andreili/UniEmu/hardware/out_buck.xlsx

 | nom | max
Vin | 5 | 5.5
Vout | 2.5
Io | 3 | 4
Fsw | 0.5
Kind | 0.2
Vpp | 0.2
R1 | 47
Lo | 4.166666667
Los | 4.7
Iripple | 0.5319148936
 | 0.580270793
Ilrms | 4.702984108
C | 2.5
R2(3.3) | 15.04 | 15 | 3.306666667
R2(2,5) | 22.11764706 | 22 | 2.509090909
R2(1,2) | 94 | 91 | 1.213186813
