andreili/UniEmu/hardware/UniEmu.kicad_pcb

## KiCad design hardware/UniEmu.kicad_pcb (2019-04-28)

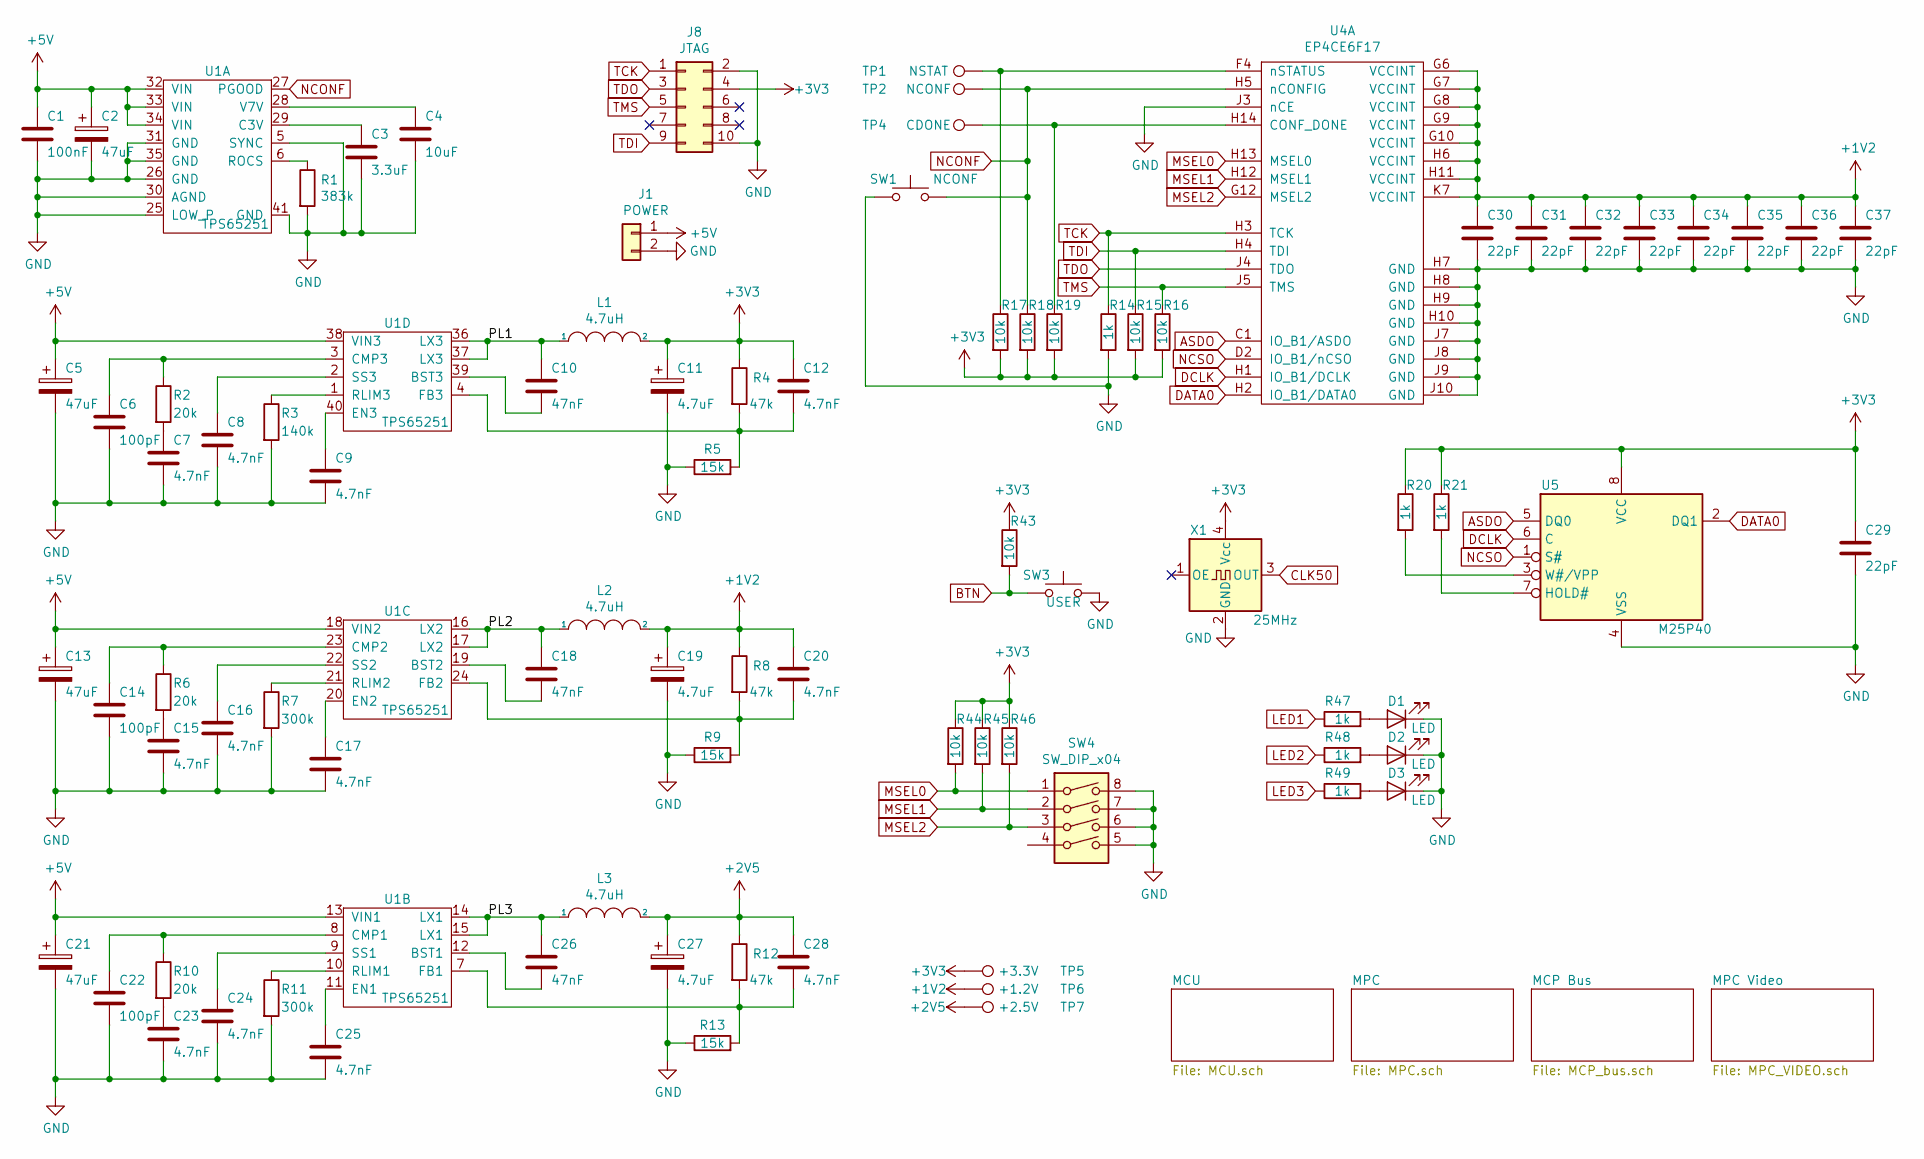
[picture p1: schematic UniEmu.sch]

Parts:
C1: 100nF; C_0805_2012Metric
C2, C5, C13, C21: 47uF; CP_EIA-3528-12_Kemet-T
C3: 3.3uF; C_0805_2012Metric
C4: 10uF; C_1206_3216Metric_Pad1.42x1.75mm_HandSolder
C6, C14, C22: 100pF; C_0805_2012Metric
C7, C8, C9, C12, C15, C16, C17, C20, C23, C24, C25, C28: 4.7nF; C_0805_2012Metric
C10, C18, C26: 47nF; C_0805_2012Metric
C11, C19, C27: 4.7uF; C_0805_2012Metric
C29, C30, C31, C32, C33, C34, C35, C36, C37: 22pF; C_0805_2012Metric
D1, D2, D3: LED; LED_0805_2012Metric_Castellated
J1: POWER; BarrelJack_Horizontal
J8: JTAG; IDC-Header_2x05_P2.54mm_Vertical
L1: 4.7uH; L_TDK_VLF10040
L2, L3: 4.7uH; L_Taiyo-Yuden_MD-4040
R1: 383k; R_0805_2012Metric
R2, R6, R10: 20k; R_0805_2012Metric
R3: 140k; R_0805_2012Metric
R4, R8, R12: 47k; R_0805_2012Metric
R5, R9, R13: 15k; R_0805_2012Metric
R7, R11: 300k; R_0805_2012Metric
R14, R20, R21, R47, R48, R49: 1k; R_0805_2012Metric
R15, R16, R17, R18, R19, R43, R44, R45, R46: 10k; R_0805_2012Metric
SW1: NCONF; SW_SPST_CK_RS282G05A3
SW3: USER; SW_SPST_CK_RS282G05A3
SW4: SW_DIP_x04; SW_DIP_SPSTx04_Slide_6.7x11.72mm_W8.61mm_P2.54mm_LowProfile
TP1: NSTAT; TestPoint_Pad_D1.5mm
TP2: NCONF; TestPoint_Pad_D1.5mm
TP4: CDONE; TestPoint_Pad_D1.5mm
TP5: +3.3V; TestPoint_Pad_D1.5mm
TP6: +1.2V; TestPoint_Pad_D1.5mm
TP7: +2.5V; TestPoint_Pad_D1.5mm
U1: TPS65251; QFN-40-1EP_6x6mm_P0.5mm_EP4.6x4.6mm_ThermalVias
U4: EP4CE6F17; BGA-256_17.0x17.0mm_Layout16x16_P1.0mm_Ball0.5mm_Pad0.4mm_N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
U5: M25P40; SOIC-8_3.9x4.9mm_P1.27mm
X1: 25MHz; Crystal_SMD_7050-4Pin_7.0x5.0mm

Connections:
+1V2: C19.1, C20.1, C30.1, C31.1, C32.1, C33.1, C34.1, C35.1, C36.1, C37.1, L2.2, R8.1, TP6.1, U4.G6 (VCCINT), U4.G7 (VCCINT), U4.G8 (VCCINT), U4.G9 (VCCINT), U4.G10 (VCCINT), U4.H6 (VCCINT), U4.H11 (VCCINT), U4.K7 (VCCINT); also elsewhere on the board
+2V5: C27.1, C28.1, L3.2, R12.1, TP7.1; also elsewhere on the board
+5V: C1.1, C2.1, C5.1, C13.1, C21.1, J1.1, U1.13 (VIN1), U1.18 (VIN2), U1.32 (VIN), U1.33 (VIN), U1.34 (VIN), U1.38 (VIN3); also elsewhere on the board
/PL1: C10.1, L1.1, U1.36 (LX3), U1.37 (LX3)
/PL2: C18.1, L2.1, U1.16 (LX2), U1.17 (LX2)
/PL3: C26.1, L3.1, U1.14 (LX1), U1.15 (LX1)
ASDO: U4.C1 (IO_B1/ASDO), U5.5 (DQ0)
BTN: R43.2, SW3.1; also elsewhere on the board
CLK50: X1.3 (OUT); also elsewhere on the board
DATA0: U4.H2 (IO_B1/DATA0), U5.2 (DQ1)
DCLK: U4.H1 (IO_B1/DCLK), U5.6 (C)
GND: C1.2, C2.2, C3.2, C4.2, C5.2, C6.2, C7.2, C8.2, C9.2, C11.2, C13.2, C14.2, C15.2, C16.2, C17.2, C19.2, C21.2, C22.2, C23.2, C24.2, C25.2, C27.2, C29.2, C30.2, C31.2, C32.2, C33.2, C34.2, C35.2, C36.2, C37.2, D1.1 (K), D2.1 (K), D3.1 (K), J1.2, J8.2, J8.10, R1.2, R3.2, R5.1, R7.2, R9.1, R11.2, R13.1, R14.2, SW1.1, SW3.2, SW4.5, SW4.6, SW4.7, SW4.8, U1.5 (SYNC), U1.25 (LOW_P), U1.26 (GND), U1.30 (AGND), U1.31 (GND), U1.35 (GND), U1.41 (GND), U4.H7 (GND), U4.H8 (GND), U4.H9 (GND), U4.H10 (GND), U4.J3 (nCE), U4.J7 (GND), U4.J8 (GND), U4.J9 (GND), U4.J10 (GND), U5.4 (VSS), X1.2 (GND); also elsewhere on the board
LED1: R47.1; also elsewhere on the board
LED2: R48.1; also elsewhere on the board
LED3: R49.1; also elsewhere on the board
MSEL0: R44.2, SW4.1, U4.H13 (MSEL0)
MSEL1: R45.2, SW4.2, U4.H12 (MSEL1)
MSEL2: R46.2, SW4.3, U4.G12 (MSEL2)
NCONF: R18.1, SW1.2, TP2.1, U1.27 (PGOOD), U4.H5 (nCONFIG)
NCSO: U4.D2 (IO_B1/nCSO), U5.1 (S#)
unnamed: C3.1, U1.29 (C3V)
unnamed: C4.1, U1.28 (V7V)
unnamed: C6.1, R2.1, U1.3 (CMP3)
unnamed: C7.1, R2.2
unnamed: C8.1, U1.2 (SS3)
unnamed: C9.1, U1.40 (EN3)
unnamed: C10.2, U1.39 (BST3)
unnamed: C12.2, R4.2, R5.2, U1.4 (FB3)
unnamed: C14.1, R6.1, U1.23 (CMP2)
unnamed: C15.1, R6.2
unnamed: C16.1, U1.22 (SS2)
unnamed: C17.1, U1.20 (EN2)
unnamed: C18.2, U1.19 (BST2)
unnamed: C20.2, R8.2, R9.2, U1.24 (FB2)
unnamed: C22.1, R10.1, U1.8 (CMP1)
unnamed: C23.1, R10.2
unnamed: C24.1, U1.9 (SS1)
unnamed: C25.1, U1.11 (EN1)
unnamed: C26.2, U1.12 (BST1)
unnamed: C28.2, R12.2, R13.2, U1.7 (FB1)
unnamed: D1.2 (A), R47.2
unnamed: D2.2 (A), R48.2
unnamed: D3.2 (A), R49.2
unnamed: R1.1, U1.6 (ROCS)
unnamed: R3.1, U1.1 (RLIM3)
unnamed: R7.1, U1.21 (RLIM2)
unnamed: R11.1, U1.10 (RLIM1)
unnamed: R17.1, TP1.1, U4.F4 (nSTATUS)
unnamed: R19.1, TP4.1, U4.H14 (CONF_DONE)
unnamed: R20.2, U5.3 (W#/VPP)
unnamed: R21.2, U5.7 (HOLD#)
TCK: J8.1, R14.1, U4.H3 (TCK)
TDI: J8.9, R15.1, U4.H4 (TDI)
TDO: J8.3, U4.J4 (TDO)
TMS: J8.5, R16.1, U4.J5 (TMS)
VREF: C11.1, C12.1, C29.1, J8.4, L1.2, R4.1, R15.2, R16.2, R17.2, R18.2, R19.2, R20.1, R21.1, R43.1, R44.1, R45.1, R46.1, TP5.1, U5.8 (VCC), X1.4 (Vcc); also elsewhere on the board

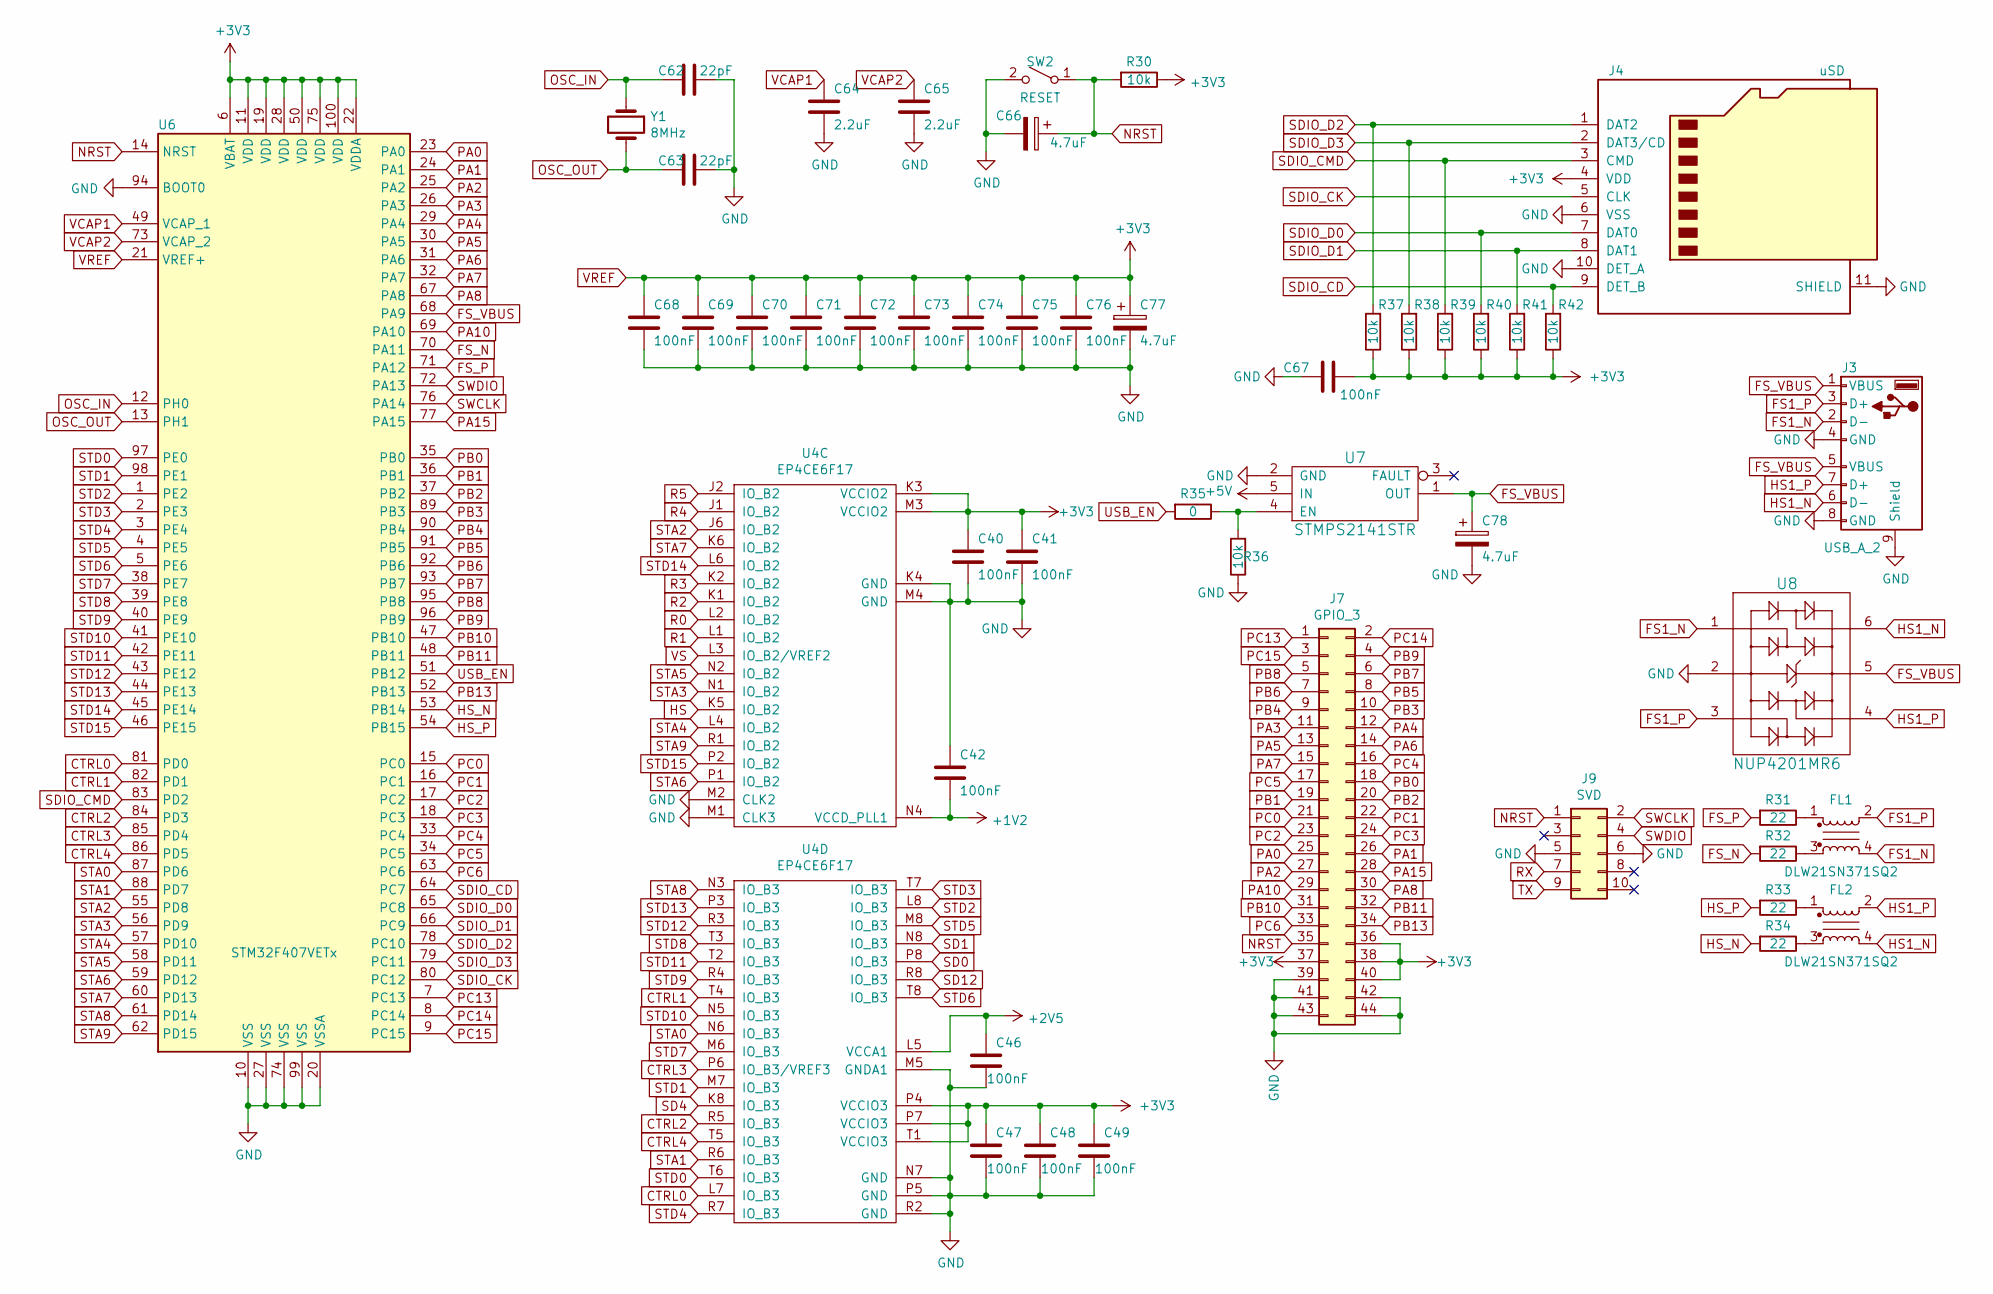
[picture p2: schematic MCU.sch]

Parts:
C40, C41, C42, C46, C47, C48, C49, C67, C68, C69, C70, C71, C72, C73, C74, C75, C76: 100nF; C_0805_2012Metric
C62, C63: 22pF; C_0805_2012Metric
C64, C65: 2.2uF; C_0805_2012Metric
C66: 4.7uF; CP_EIA-3216-18_Kemet-A
C77, C78: 4.7uF; CP_EIA-3528-12_Kemet-T
FL1, FL2: DLW21SN371SQ2; DLW21S
J3: USB_A_2; USB_A_Wuerth_61400826021_Horizontal_Stacked
J4: uSD; Conn_uSDcard
J7: GPIO_3; PinSocket_2x22_P2.00mm_Vertical
J9: SVD; IDC-Header_2x05_P2.54mm_Vertical
R30, R36, R37, R38, R39, R40, R41, R42: 10k; R_0805_2012Metric
R31, R32, R33, R34: 22; R_0402_1005Metric
R35: 0; R_0805_2012Metric
SW2: RESET; SW_Tactile_SPST_Angled_PTS645Vx39-2LFS
U4: EP4CE6F17; BGA-256_17.0x17.0mm_Layout16x16_P1.0mm_Ball0.5mm_Pad0.4mm_N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
U6: STM32F407VETx; LQFP-100_14x14mm_P0.5mm
U7: STMPS2141STR; SOT-23-5_HandSoldering
U8: NUP4201MR6; TSOP-6_1.65x3.05mm_P0.95mm
Y1: 8MHz; Crystal_SMD_5032-2Pin_5.0x3.2mm

Connections:
+1V2: C42.2, U4.N4 (VCCD_PLL1); also elsewhere on the board
+2V5: C46.1, U4.L5 (VCCA1); also elsewhere on the board
+5V: U7.5 (IN); also elsewhere on the board
CTRL0: U4.L7 (IO_B3), U6.81 (PD0)
CTRL1: U4.T4 (IO_B3), U6.82 (PD1)
CTRL2: U4.R5 (IO_B3), U6.84 (PD3)
CTRL3: U4.P6 (IO_B3/VREF3), U6.85 (PD4)
CTRL4: U4.T5 (IO_B3), U6.86 (PD5)
FS1_N: FL1.4, J3.2 (D-), U8.1
FS1_P: FL1.2, J3.3 (D+), U8.3
FS_N: R32.2, U6.70 (PA11)
FS_P: R31.2, U6.71 (PA12)
FS_VBUS: C78.1, J3.1 (VBUS), J3.5 (VBUS), U6.68 (PA9), U7.1 (OUT), U8.5
GND: C40.2, C41.2, C42.1, C46.2, C47.2, C48.2, C49.2, C62.1, C63.1, C64.2, C65.2, C66.2, C67.1, C68.2, C69.2, C70.2, C71.2, C72.2, C73.2, C74.2, C75.2, C76.2, C77.2, C78.2, J3.4 (GND), J3.8 (GND), J3.9 (Shield), J4.6 (VSS), J4.10 (DET_A), J4.11 (SHIELD), J7.39, J7.41, J7.42, J7.43, J7.44, J9.5, J9.6, R36.1, SW2.2 (B), U4.K4 (GND), U4.M1 (CLK3), U4.M2 (CLK2), U4.M4 (GND), U4.M5 (GNDA1), U4.N7 (GND), U4.P5 (GND), U4.R2 (GND), U6.10 (VSS), U6.20 (VSSA), U6.27 (VSS), U6.74 (VSS), U6.94 (BOOT0), U6.99 (VSS), U7.2 (GND), U8.2; also elsewhere on the board
HS: U4.K5 (IO_B2); also elsewhere on the board
HS1_N: FL2.4, J3.6 (D-), U8.6
HS1_P: FL2.2, J3.7 (D+), U8.4
HS_N: R34.2, U6.53 (PB14)
HS_P: R33.2, U6.54 (PB15)
NRST: C66.1, J7.35, J9.1, R30.2, SW2.1 (A), U6.14 (NRST)
unnamed: FL1.1, R31.1
unnamed: FL1.3, R32.1
unnamed: FL2.1, R33.1
unnamed: FL2.3, R34.1
unnamed: R35.1, R36.2, U7.4 (EN)
OSC_IN: C62.2, U6.12 (PH0), Y1.1
OSC_OUT: C63.2, U6.13 (PH1), Y1.2
PA0: J7.25, U6.23 (PA0)
PA1: J7.26, U6.24 (PA1)
PA2: J7.27, U6.25 (PA2)
PA3: J7.11, U6.26 (PA3)
PA4: J7.12, U6.29 (PA4)
PA5: J7.13, U6.30 (PA5)
PA6: J7.14, U6.31 (PA6)
PA7: J7.15, U6.32 (PA7)
PA8: J7.30, U6.67 (PA8)
PA10: J7.29, U6.69 (PA10)
PA15: J7.28, U6.77 (PA15)
PB0: J7.18, U6.35 (PB0)
PB1: J7.19, U6.36 (PB1)
PB2: J7.20, U6.37 (PB2)
PB3: J7.10, U6.89 (PB3)
PB4: J7.9, U6.90 (PB4)
PB5: J7.8, U6.91 (PB5)
PB6: J7.7, U6.92 (PB6)
PB7: J7.6, U6.93 (PB7)
PB8: J7.5, U6.95 (PB8)
PB9: J7.4, U6.96 (PB9)
PB10: J7.31, U6.47 (PB10)
PB11: J7.32, U6.48 (PB11)
PB13: J7.34, U6.52 (PB13)
PC0: J7.21, U6.15 (PC0)
PC1: J7.22, U6.16 (PC1)
PC2: J7.23, U6.17 (PC2)
PC3: J7.24, U6.18 (PC3)
PC4: J7.16, U6.33 (PC4)
PC5: J7.17, U6.34 (PC5)
PC6: J7.33, U6.63 (PC6)
PC13: J7.1, U6.7 (PC13)
PC14: J7.2, U6.8 (PC14)
PC15: J7.3, U6.9 (PC15)
R0: U4.L2 (IO_B2); also elsewhere on the board
R1: U4.L1 (IO_B2); also elsewhere on the board
R2: U4.K1 (IO_B2); also elsewhere on the board
R3: U4.K2 (IO_B2); also elsewhere on the board
R4: U4.J1 (IO_B2); also elsewhere on the board
R5: U4.J2 (IO_B2); also elsewhere on the board
RX: J9.7
SD0: U4.P8 (IO_B3); also elsewhere on the board
SD1: U4.N8 (IO_B3); also elsewhere on the board
SD4: U4.K8 (IO_B3); also elsewhere on the board
SD12: U4.R8 (IO_B3); also elsewhere on the board
SDIO_CD: J4.9 (DET_B), R42.2, U6.64 (PC7)
SDIO_CK: J4.5 (CLK), U6.80 (PC12)
SDIO_CMD: J4.3 (CMD), R39.2, U6.83 (PD2)
SDIO_D0: J4.7 (DAT0), R40.2, U6.65 (PC8)
SDIO_D1: J4.8 (DAT1), R41.2, U6.66 (PC9)
SDIO_D2: J4.1 (DAT2), R37.2, U6.78 (PC10)
SDIO_D3: J4.2 (DAT3/CD), R38.2, U6.79 (PC11)
STA0: U4.N6 (IO_B3), U6.87 (PD6)
STA1: U4.R6 (IO_B3), U6.88 (PD7)
STA2: U4.J6 (IO_B2), U6.55 (PD8)
STA3: U4.N1 (IO_B2), U6.56 (PD9)
STA4: U4.L4 (IO_B2), U6.57 (PD10)
STA5: U4.N2 (IO_B2), U6.58 (PD11)
STA6: U4.P1 (IO_B2), U6.59 (PD12)
STA7: U4.K6 (IO_B2), U6.60 (PD13)
STA8: U4.N3 (IO_B3), U6.61 (PD14)
STA9: U4.R1 (IO_B2), U6.62 (PD15)
STD0: U4.T6 (IO_B3), U6.97 (PE0)
STD1: U4.M7 (IO_B3), U6.98 (PE1)
STD2: U4.L8 (IO_B3), U6.1 (PE2)
STD3: U4.T7 (IO_B3), U6.2 (PE3)
STD4: U4.R7 (IO_B3), U6.3 (PE4)
STD5: U4.M8 (IO_B3), U6.4 (PE5)
STD6: U4.T8 (IO_B3), U6.5 (PE6)
STD7: U4.M6 (IO_B3), U6.38 (PE7)
STD8: U4.T3 (IO_B3), U6.39 (PE8)
STD9: U4.R4 (IO_B3), U6.40 (PE9)
STD10: U4.N5 (IO_B3), U6.41 (PE10)
STD11: U4.T2 (IO_B3), U6.42 (PE11)
STD12: U4.R3 (IO_B3), U6.43 (PE12)
STD13: U4.P3 (IO_B3), U6.44 (PE13)
STD14: U4.L6 (IO_B2), U6.45 (PE14)
STD15: U4.P2 (IO_B2), U6.46 (PE15)
SWCLK: J9.2, U6.76 (PA14)
SWDIO: J9.4, U6.72 (PA13)
TX: J9.9
USB_EN: R35.2, U6.51 (PB12)
VCAP1: C64.1, U6.49 (VCAP_1)
VCAP2: C65.1, U6.73 (VCAP_2)
VREF: C40.1, C41.1, C47.1, C48.1, C49.1, C67.2, C68.1, C69.1, C70.1, C71.1, C72.1, C73.1, C74.1, C75.1, C76.1, C77.1, J4.4 (VDD), J7.36, J7.37, J7.38, J7.40, R30.1, R37.1, R38.1, R39.1, R40.1, R41.1, R42.1, U4.K3 (VCCIO2), U4.M3 (VCCIO2), U4.P4 (VCCIO3), U4.P7 (VCCIO3), U4.T1 (VCCIO3), U6.6 (VBAT), U6.11 (VDD), U6.19 (VDD), U6.21 (VREF+), U6.22 (VDDA), U6.28 (VDD), U6.50 (VDD), U6.75 (VDD), U6.100 (VDD); also elsewhere on the board
VS: U4.L3 (IO_B2/VREF2); also elsewhere on the board

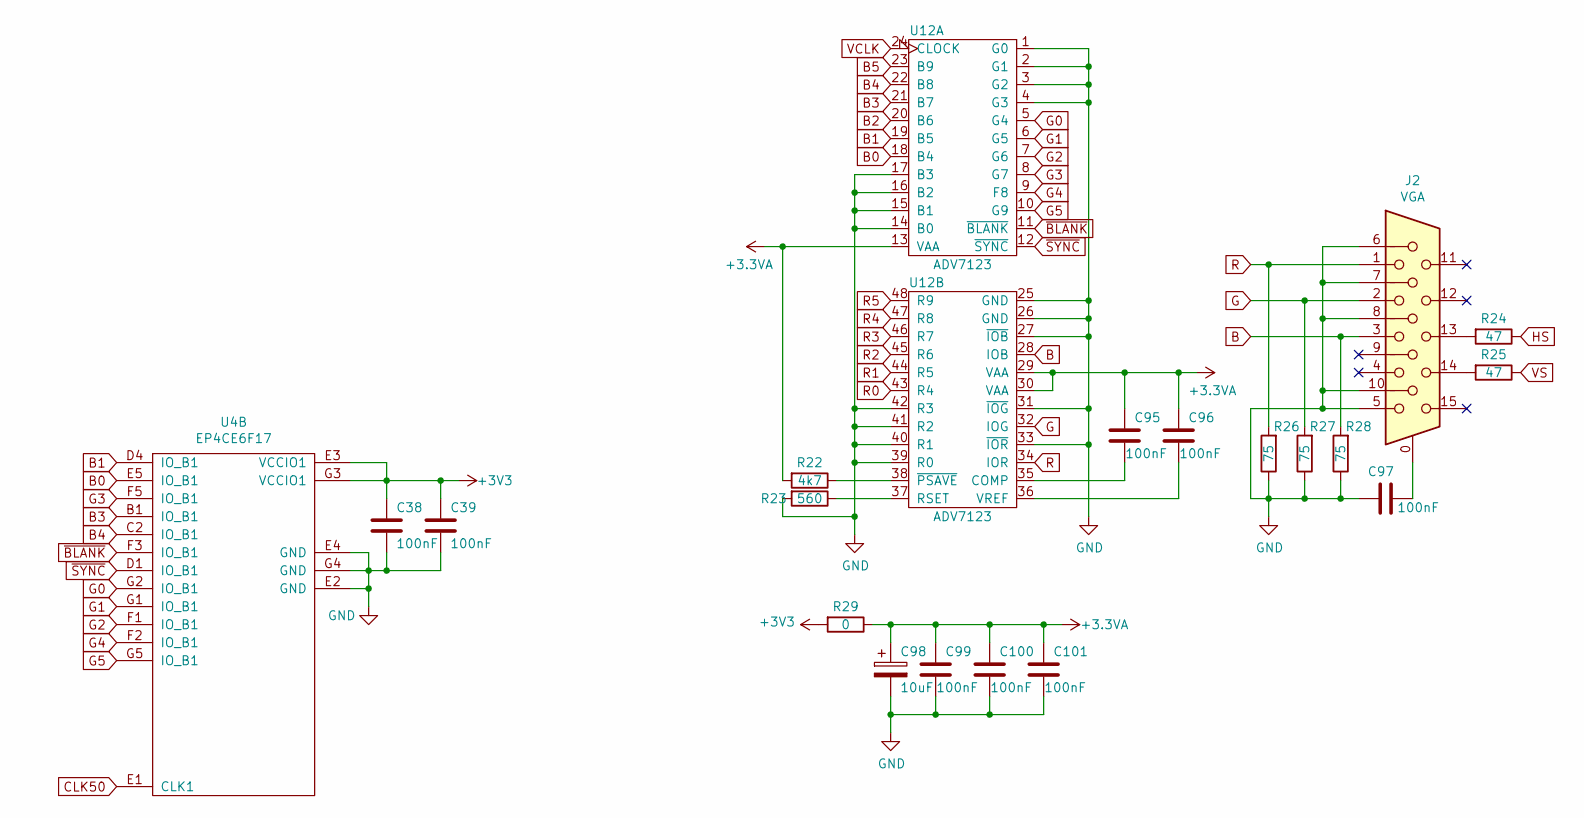
[picture p3: schematic MPC_VIDEO.sch]

Parts:
C38, C39, C95, C96, C97, C99, C100, C101: 100nF; C_0805_2012Metric
C98: 10uF; CP_EIA-3528-12_Kemet-T
J2: VGA; DSUB-15-HD_Female_Horizontal_P2.29x1.98mm_EdgePinOffset3.03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
R22: 4k7; R_0805_2012Metric
R23: 560; R_0805_2012Metric
R24, R25: 47; R_0805_2012Metric
R26, R27, R28: 75; R_0805_2012Metric
R29: 0; R_0805_2012Metric
U4: EP4CE6F17; BGA-256_17.0x17.0mm_Layout16x16_P1.0mm_Ball0.5mm_Pad0.4mm_N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
U12: ADV7123; LQFP-48_7x7mm_P0.5mm

Connections:
+3.3VA: C95.1, C96.1, C98.1, C99.1, C100.1, C101.1, R22.2, R29.1, U12.13 (VAA), U12.29 (VAA), U12.30 (VAA)
B: J2.3, R28.2, U12.28 (IOB)
B0: U4.E5 (IO_B1), U12.18 (B4)
B1: U4.D4 (IO_B1), U12.19 (B5)
B2: U12.20 (B6); also elsewhere on the board
B3: U4.B1 (IO_B1), U12.21 (B7)
B4: U4.C2 (IO_B1), U12.22 (B8)
B5: U12.23 (B9); also elsewhere on the board
CLK50: U4.E1 (CLK1); also elsewhere on the board
G: J2.2, R27.2, U12.32 (IOG)
G0: U4.G2 (IO_B1), U12.5 (G4)
G1: U4.G1 (IO_B1), U12.6 (G5)
G2: U4.F1 (IO_B1), U12.7 (G6)
G3: U4.F5 (IO_B1), U12.8 (G7)
G4: U4.F2 (IO_B1), U12.9 (F8)
G5: U4.G5 (IO_B1), U12.10 (G9)
GND: C38.2, C39.2, C97.1, C98.2, C99.2, C100.2, C101.2, J2.5, J2.6, J2.7, J2.8, J2.10, R23.2, R26.1, R27.1, R28.1, U4.E2 (GND), U4.E4 (GND), U4.G4 (GND), U12.1 (G0), U12.2 (G1), U12.3 (G2), U12.4 (G3), U12.14 (B0), U12.15 (B1), U12.16 (B2), U12.17 (B3), U12.25 (GND), U12.26 (GND), U12.27 (~IOB), U12.31 (~IOG), U12.33 (~IOR), U12.39 (R0), U12.40 (R1), U12.41 (R2), U12.42 (R3); also elsewhere on the board
HS: R24.1; also elsewhere on the board
unnamed: C95.2, U12.35 (COMP)
unnamed: C96.2, U12.36 (VREF)
unnamed: C97.2, J2.0
unnamed: J2.13, R24.2
unnamed: J2.14, R25.2
unnamed: R22.1, U12.38 (~PSAVE)
unnamed: R23.1, U12.37 (RSET)
R: J2.1, R26.2, U12.34 (IOR)
R0: U12.43 (R4); also elsewhere on the board
R1: U12.44 (R5); also elsewhere on the board
R2: U12.45 (R6); also elsewhere on the board
R3: U12.46 (R7); also elsewhere on the board
R4: U12.47 (R8); also elsewhere on the board
R5: U12.48 (R9); also elsewhere on the board
VCLK: U12.24 (CLOCK); also elsewhere on the board
VREF: C38.1, C39.1, R29.2, U4.E3 (VCCIO1), U4.G3 (VCCIO1); also elsewhere on the board
VS: R25.1; also elsewhere on the board
~BLANK: U4.F3 (IO_B1), U12.11 (~BLANK)
~SYNC: U4.D1 (IO_B1), U12.12 (~SYNC)

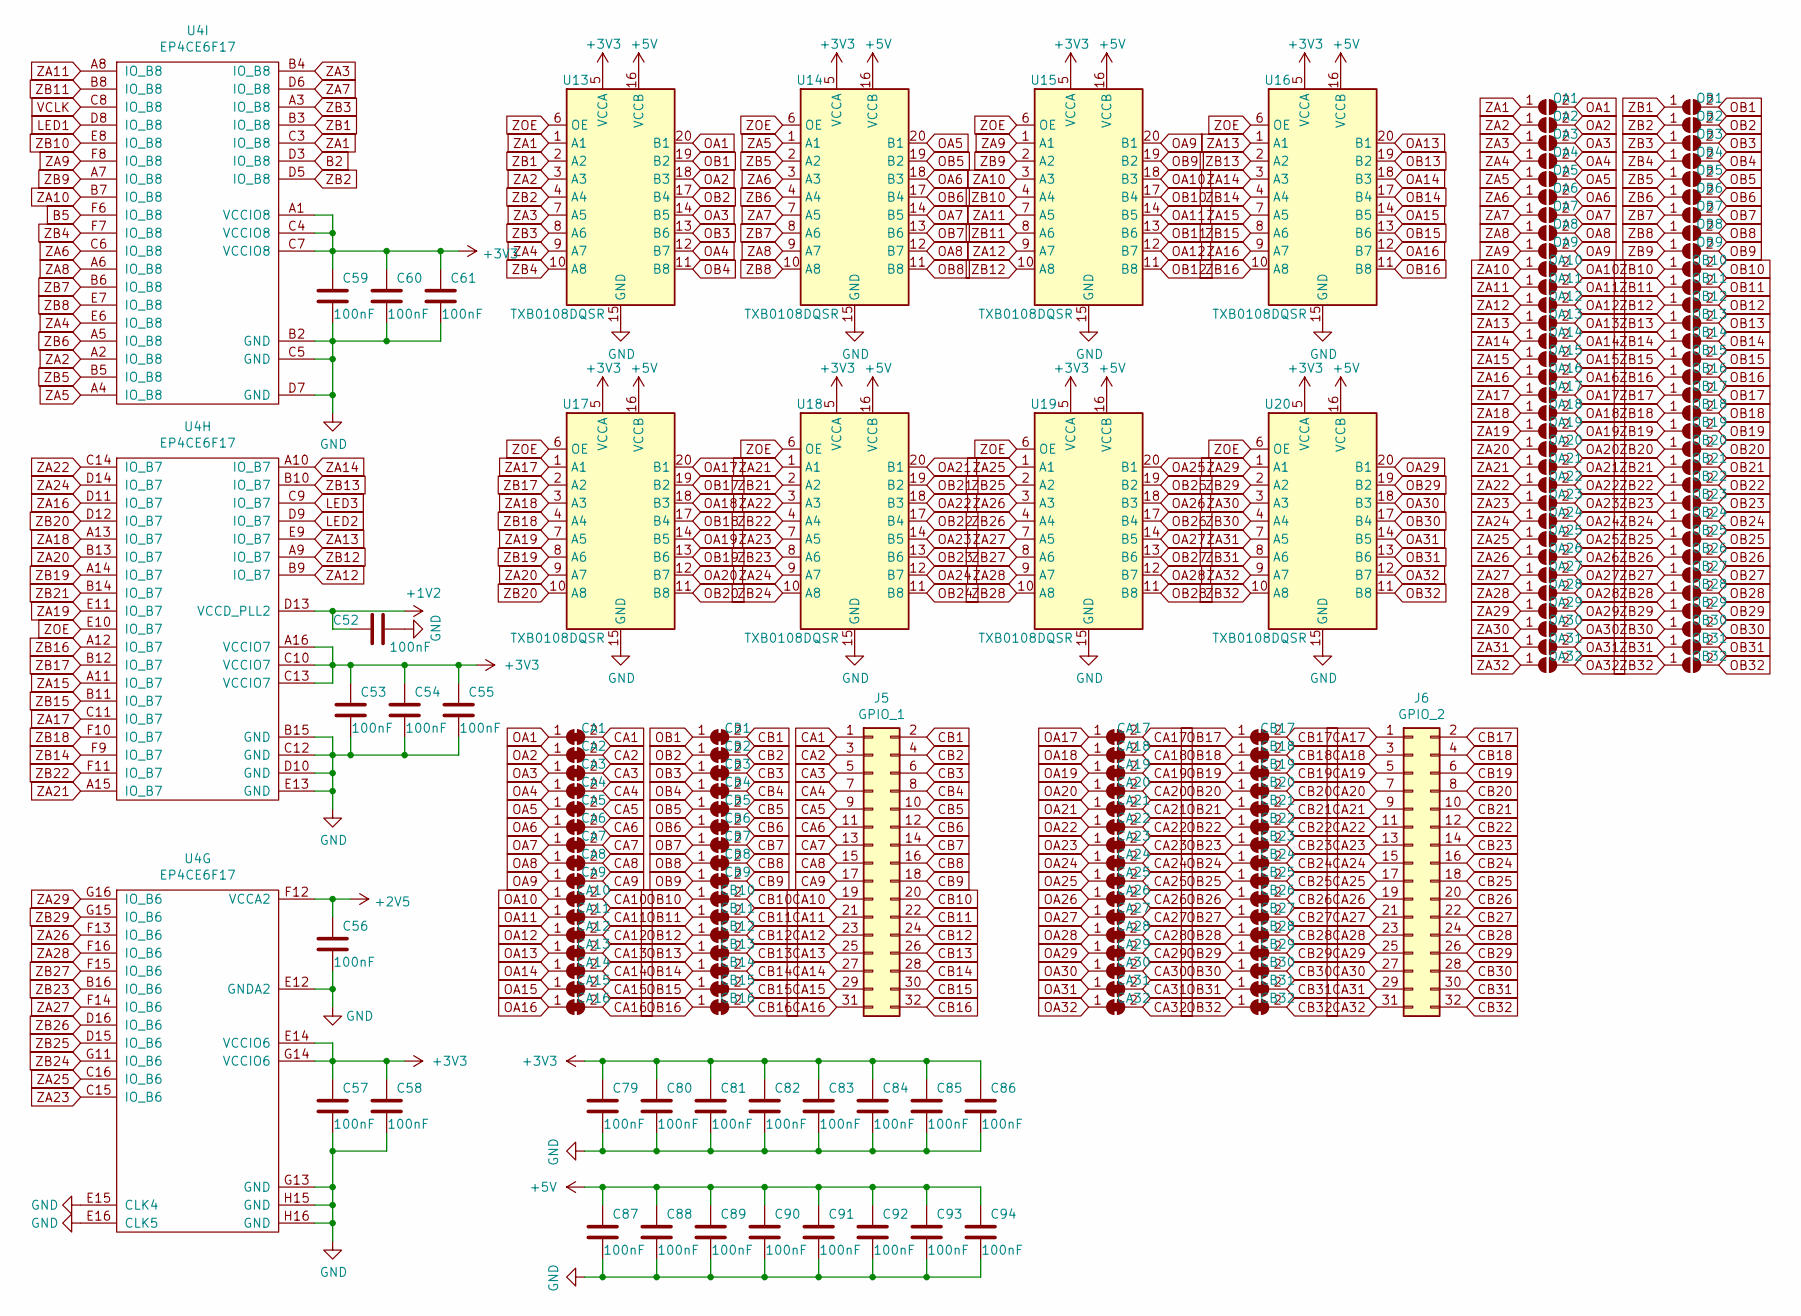
[picture p4: schematic MCP_bus.sch]

Parts:
C52, C53, C54, C55, C56, C57, C58, C59, C60, C61, C79, C80, C81, C82, C83, C84, C85, C86, C87, C88, C89, C90, C91, C92, C93, C94: 100nF; C_0805_2012Metric
CA1, CA2, CA3, CA4, CA5, CA6, CA7, CA8, CA9, CA10, CA11, CA12, CA13, CA14, CA15, CA16, CA17, CA18, CA19, CA20, CA21, CA22, CA23, CA24, CA25, CA26, CA27, CA28, CA29, CA30, CA31, CA32: SolderJumper_2_Bridged; SolderJumper-2_P1.3mm_Bridged_Pad1.0x1.5mm
CB1, CB2, CB3, CB4, CB5, CB6, CB7, CB8, CB9, CB10, CB11, CB12, CB13, CB14, CB15, CB16, CB17, CB18, CB19, CB20, CB21, CB22, CB23, CB24, CB25, CB26, CB27, CB28, CB29, CB30, CB31, CB32: SolderJumper_2_Bridged; SolderJumper-2_P1.3mm_Bridged_Pad1.0x1.5mm
J5: GPIO_1; PinHeader_2x16_P2.54mm_Vertical
J6: GPIO_2; PinHeader_2x16_P2.54mm_Vertical
OA1, OA2, OA3, OA4, OA5, OA6, OA7, OA8, OA9, OA10, OA11, OA12, OA13, OA14, OA15, OA16, OA17, OA18, OA19, OA20, OA21, OA22, OA23, OA24, OA25, OA26, OA27, OA28, OA29, OA30, OA31, OA32: OA1; SolderJumper-2_P0.4mm_Open_TrianglePad
OB1, OB2, OB3, OB4, OB5, OB6, OB7, OB8, OB9, OB10, OB11, OB12, OB13, OB14, OB15, OB16, OB17, OB18, OB19, OB20, OB21, OB22, OB23, OB24, OB25, OB26, OB27, OB28, OB29, OB30, OB31, OB32: OA1; SolderJumper-2_P0.4mm_Open_TrianglePad
U4: EP4CE6F17; BGA-256_17.0x17.0mm_Layout16x16_P1.0mm_Ball0.5mm_Pad0.4mm_N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
U13, U14, U15, U16, U17, U18, U19, U20: TXB0108DQSR; TSSOP-20_4.4x6.5mm_P0.65mm

Connections:
+1V2: C52.1, U4.D13 (VCCD_PLL2); also elsewhere on the board
+2V5: C56.1, U4.F12 (VCCA2); also elsewhere on the board
+5V: C87.1, C88.1, C89.1, C90.1, C91.1, C92.1, C93.1, C94.1, U13.16 (VCCB), U14.16 (VCCB), U15.16 (VCCB), U16.16 (VCCB), U17.16 (VCCB), U18.16 (VCCB), U19.16 (VCCB), U20.16 (VCCB); also elsewhere on the board
B2: U4.D3 (IO_B8); also elsewhere on the board
B5: U4.F6 (IO_B8); also elsewhere on the board
CA1: CA1.2 (B), J5.1
CA2: CA2.2 (B), J5.3
CA3: CA3.2 (B), J5.5
CA4: CA4.2 (B), J5.7
CA5: CA5.2 (B), J5.9
CA6: CA6.2 (B), J5.11
CA7: CA7.2 (B), J5.13
CA8: CA8.2 (B), J5.15
CA9: CA9.2 (B), J5.17
CA10: CA10.2 (B), J5.19
CA11: CA11.2 (B), J5.21
CA12: CA12.2 (B), J5.23
CA13: CA13.2 (B), J5.25
CA14: CA14.2 (B), J5.27
CA15: CA15.2 (B), J5.29
CA16: CA16.2 (B), J5.31
CA17: CA17.2 (B), J6.1
CA18: CA18.2 (B), J6.3
CA19: CA19.2 (B), J6.5
CA20: CA20.2 (B), J6.7
CA21: CA21.2 (B), J6.9
CA22: CA22.2 (B), J6.11
CA23: CA23.2 (B), J6.13
CA24: CA24.2 (B), J6.15
CA25: CA25.2 (B), J6.17
CA26: CA26.2 (B), J6.19
CA27: CA27.2 (B), J6.21
CA28: CA28.2 (B), J6.23
CA29: CA29.2 (B), J6.25
CA30: CA30.2 (B), J6.27
CA31: CA31.2 (B), J6.29
CA32: CA32.2 (B), J6.31
CB1: CB1.2 (B), J5.2
CB2: CB2.2 (B), J5.4
CB3: CB3.2 (B), J5.6
CB4: CB4.2 (B), J5.8
CB5: CB5.2 (B), J5.10
CB6: CB6.2 (B), J5.12
CB7: CB7.2 (B), J5.14
CB8: CB8.2 (B), J5.16
CB9: CB9.2 (B), J5.18
CB10: CB10.2 (B), J5.20
CB11: CB11.2 (B), J5.22
CB12: CB12.2 (B), J5.24
CB13: CB13.2 (B), J5.26
CB14: CB14.2 (B), J5.28
CB15: CB15.2 (B), J5.30
CB16: CB16.2 (B), J5.32
CB17: CB17.2 (B), J6.2
CB18: CB18.2 (B), J6.4
CB19: CB19.2 (B), J6.6
CB20: CB20.2 (B), J6.8
CB21: CB21.2 (B), J6.10
CB22: CB22.2 (B), J6.12
CB23: CB23.2 (B), J6.14
CB24: CB24.2 (B), J6.16
CB25: CB25.2 (B), J6.18
CB26: CB26.2 (B), J6.20
CB27: CB27.2 (B), J6.22
CB28: CB28.2 (B), J6.24
CB29: CB29.2 (B), J6.26
CB30: CB30.2 (B), J6.28
CB31: CB31.2 (B), J6.30
CB32: CB32.2 (B), J6.32
GND: C52.2, C53.2, C54.2, C55.2, C56.2, C57.2, C58.2, C59.2, C60.2, C61.2, C79.2, C80.2, C81.2, C82.2, C83.2, C84.2, C85.2, C86.2, C87.2, C88.2, C89.2, C90.2, C91.2, C92.2, C93.2, C94.2, U4.B2 (GND), U4.B15 (GND), U4.C5 (GND), U4.C12 (GND), U4.D7 (GND), U4.D10 (GND), U4.E12 (GNDA2), U4.E13 (GND), U4.E15 (CLK4), U4.E16 (CLK5), U4.G13 (GND), U4.H15 (GND), U4.H16 (GND), U13.15 (GND), U14.15 (GND), U15.15 (GND), U16.15 (GND), U17.15 (GND), U18.15 (GND), U19.15 (GND), U20.15 (GND); also elsewhere on the board
LED1: U4.D8 (IO_B8); also elsewhere on the board
LED2: U4.D9 (IO_B7); also elsewhere on the board
LED3: U4.C9 (IO_B7); also elsewhere on the board
OA1: CA1.1 (A), OA1.2 (B), U13.20 (B1)
OA2: CA2.1 (A), OA2.2 (B), U13.18 (B3)
OA3: CA3.1 (A), OA3.2 (B), U13.14 (B5)
OA4: CA4.1 (A), OA4.2 (B), U13.12 (B7)
OA5: CA5.1 (A), OA5.2 (B), U14.20 (B1)
OA6: CA6.1 (A), OA6.2 (B), U14.18 (B3)
OA7: CA7.1 (A), OA7.2 (B), U14.14 (B5)
OA8: CA8.1 (A), OA8.2 (B), U14.12 (B7)
OA9: CA9.1 (A), OA9.2 (B), U15.20 (B1)
OA10: CA10.1 (A), OA10.2 (B), U15.18 (B3)
OA11: CA11.1 (A), OA11.2 (B), U15.14 (B5)
OA12: CA12.1 (A), OA12.2 (B), U15.12 (B7)
OA13: CA13.1 (A), OA13.2 (B), U16.20 (B1)
OA14: CA14.1 (A), OA14.2 (B), U16.18 (B3)
OA15: CA15.1 (A), OA15.2 (B), U16.14 (B5)
OA16: CA16.1 (A), OA16.2 (B), U16.12 (B7)
OA17: CA17.1 (A), OA17.2 (B), U17.20 (B1)
OA18: CA18.1 (A), OA18.2 (B), U17.18 (B3)
OA19: CA19.1 (A), OA19.2 (B), U17.14 (B5)
OA20: CA20.1 (A), OA20.2 (B), U17.12 (B7)
OA21: CA21.1 (A), OA21.2 (B), U18.20 (B1)
OA22: CA22.1 (A), OA22.2 (B), U18.18 (B3)
OA23: CA23.1 (A), OA23.2 (B), U18.14 (B5)
OA24: CA24.1 (A), OA24.2 (B), U18.12 (B7)
OA25: CA25.1 (A), OA25.2 (B), U19.20 (B1)
OA26: CA26.1 (A), OA26.2 (B), U19.18 (B3)
OA27: CA27.1 (A), OA27.2 (B), U19.14 (B5)
OA28: CA28.1 (A), OA28.2 (B), U19.12 (B7)
OA29: CA29.1 (A), OA29.2 (B), U20.20 (B1)
OA30: CA30.1 (A), OA30.2 (B), U20.18 (B3)
OA31: CA31.1 (A), OA31.2 (B), U20.14 (B5)
OA32: CA32.1 (A), OA32.2 (B), U20.12 (B7)
OB1: CB1.1 (A), OB1.2 (B), U13.19 (B2)
OB2: CB2.1 (A), OB2.2 (B), U13.17 (B4)
OB3: CB3.1 (A), OB3.2 (B), U13.13 (B6)
OB4: CB4.1 (A), OB4.2 (B), U13.11 (B8)
OB5: CB5.1 (A), OB5.2 (B), U14.19 (B2)
OB6: CB6.1 (A), OB6.2 (B), U14.17 (B4)
OB7: CB7.1 (A), OB7.2 (B), U14.13 (B6)
OB8: CB8.1 (A), OB8.2 (B), U14.11 (B8)
OB9: CB9.1 (A), OB9.2 (B), U15.19 (B2)
OB10: CB10.1 (A), OB10.2 (B), U15.17 (B4)
OB11: CB11.1 (A), OB11.2 (B), U15.13 (B6)
OB12: CB12.1 (A), OB12.2 (B), U15.11 (B8)
OB13: CB13.1 (A), OB13.2 (B), U16.19 (B2)
OB14: CB14.1 (A), OB14.2 (B), U16.17 (B4)
OB15: CB15.1 (A), OB15.2 (B), U16.13 (B6)
OB16: CB16.1 (A), OB16.2 (B), U16.11 (B8)
OB17: CB17.1 (A), OB17.2 (B), U17.19 (B2)
OB18: CB18.1 (A), OB18.2 (B), U17.17 (B4)
OB19: CB19.1 (A), OB19.2 (B), U17.13 (B6)
OB20: CB20.1 (A), OB20.2 (B), U17.11 (B8)
OB21: CB21.1 (A), OB21.2 (B), U18.19 (B2)
OB22: CB22.1 (A), OB22.2 (B), U18.17 (B4)
OB23: CB23.1 (A), OB23.2 (B), U18.13 (B6)
OB24: CB24.1 (A), OB24.2 (B), U18.11 (B8)
OB25: CB25.1 (A), OB25.2 (B), U19.19 (B2)
OB26: CB26.1 (A), OB26.2 (B), U19.17 (B4)
OB27: CB27.1 (A), OB27.2 (B), U19.13 (B6)
OB28: CB28.1 (A), OB28.2 (B), U19.11 (B8)
OB29: CB29.1 (A), OB29.2 (B), U20.19 (B2)
OB30: CB30.1 (A), OB30.2 (B), U20.17 (B4)
OB31: CB31.1 (A), OB31.2 (B), U20.13 (B6)
OB32: CB32.1 (A), OB32.2 (B), U20.11 (B8)
VCLK: U4.C8 (IO_B8); also elsewhere on the board
VREF: C53.1, C54.1, C55.1, C57.1, C58.1, C59.1, C60.1, C61.1, C79.1, C80.1, C81.1, C82.1, C83.1, C84.1, C85.1, C86.1, U4.A1 (VCCIO8), U4.A16 (VCCIO7), U4.C4 (VCCIO8), U4.C7 (VCCIO8), U4.C10 (VCCIO7), U4.C13 (VCCIO7), U4.E14 (VCCIO6), U4.G14 (VCCIO6), U13.5 (VCCA), U14.5 (VCCA), U15.5 (VCCA), U16.5 (VCCA), U17.5 (VCCA), U18.5 (VCCA), U19.5 (VCCA), U20.5 (VCCA); also elsewhere on the board
ZA1: OA1.1 (A), U4.C3 (IO_B8), U13.1 (A1)
ZA2: OA2.1 (A), U4.A2 (IO_B8), U13.3 (A3)
ZA3: OA3.1 (A), U4.B4 (IO_B8), U13.7 (A5)
ZA4: OA4.1 (A), U4.E6 (IO_B8), U13.9 (A7)
ZA5: OA5.1 (A), U4.A4 (IO_B8), U14.1 (A1)
ZA6: OA6.1 (A), U4.C6 (IO_B8), U14.3 (A3)
ZA7: OA7.1 (A), U4.D6 (IO_B8), U14.7 (A5)
ZA8: OA8.1 (A), U4.A6 (IO_B8), U14.9 (A7)
ZA9: OA9.1 (A), U4.F8 (IO_B8), U15.1 (A1)
ZA10: OA10.1 (A), U4.B7 (IO_B8), U15.3 (A3)
ZA11: OA11.1 (A), U4.A8 (IO_B8), U15.7 (A5)
ZA12: OA12.1 (A), U4.B9 (IO_B7), U15.9 (A7)
ZA13: OA13.1 (A), U4.E9 (IO_B7), U16.1 (A1)
ZA14: OA14.1 (A), U4.A10 (IO_B7), U16.3 (A3)
ZA15: OA15.1 (A), U4.A11 (IO_B7), U16.7 (A5)
ZA16: OA16.1 (A), U4.D11 (IO_B7), U16.9 (A7)
ZA17: OA17.1 (A), U4.C11 (IO_B7), U17.1 (A1)
ZA18: OA18.1 (A), U4.A13 (IO_B7), U17.3 (A3)
ZA19: OA19.1 (A), U4.E11 (IO_B7), U17.7 (A5)
ZA20: OA20.1 (A), U4.B13 (IO_B7), U17.9 (A7)
ZA21: OA21.1 (A), U4.A15 (IO_B7), U18.1 (A1)
ZA22: OA22.1 (A), U4.C14 (IO_B7), U18.3 (A3)
ZA23: OA23.1 (A), U4.C15 (IO_B6), U18.7 (A5)
ZA24: OA24.1 (A), U4.D14 (IO_B7), U18.9 (A7)
ZA25: OA25.1 (A), U4.C16 (IO_B6), U19.1 (A1)
ZA26: OA26.1 (A), U4.F13 (IO_B6), U19.3 (A3)
ZA27: OA27.1 (A), U4.F14 (IO_B6), U19.7 (A5)
ZA28: OA28.1 (A), U4.F16 (IO_B6), U19.9 (A7)
ZA29: OA29.1 (A), U4.G16 (IO_B6), U20.1 (A1)
ZA30: OA30.1 (A), U20.3 (A3); also elsewhere on the board
ZA31: OA31.1 (A), U20.7 (A5); also elsewhere on the board
ZA32: OA32.1 (A), U20.9 (A7); also elsewhere on the board
ZB1: OB1.1 (A), U4.B3 (IO_B8), U13.2 (A2)
ZB2: OB2.1 (A), U4.D5 (IO_B8), U13.4 (A4)
ZB3: OB3.1 (A), U4.A3 (IO_B8), U13.8 (A6)
ZB4: OB4.1 (A), U4.F7 (IO_B8), U13.10 (A8)
ZB5: OB5.1 (A), U4.B5 (IO_B8), U14.2 (A2)
ZB6: OB6.1 (A), U4.A5 (IO_B8), U14.4 (A4)
ZB7: OB7.1 (A), U4.B6 (IO_B8), U14.8 (A6)
ZB8: OB8.1 (A), U4.E7 (IO_B8), U14.10 (A8)
ZB9: OB9.1 (A), U4.A7 (IO_B8), U15.2 (A2)
ZB10: OB10.1 (A), U4.E8 (IO_B8), U15.4 (A4)
ZB11: OB11.1 (A), U4.B8 (IO_B8), U15.8 (A6)
ZB12: OB12.1 (A), U4.A9 (IO_B7), U15.10 (A8)
ZB13: OB13.1 (A), U4.B10 (IO_B7), U16.2 (A2)
ZB14: OB14.1 (A), U4.F9 (IO_B7), U16.4 (A4)
ZB15: OB15.1 (A), U4.B11 (IO_B7), U16.8 (A6)
ZB16: OB16.1 (A), U4.A12 (IO_B7), U16.10 (A8)
ZB17: OB17.1 (A), U4.B12 (IO_B7), U17.2 (A2)
ZB18: OB18.1 (A), U4.F10 (IO_B7), U17.4 (A4)
ZB19: OB19.1 (A), U4.A14 (IO_B7), U17.8 (A6)
ZB20: OB20.1 (A), U4.D12 (IO_B7), U17.10 (A8)
ZB21: OB21.1 (A), U4.B14 (IO_B7), U18.2 (A2)
ZB22: OB22.1 (A), U4.F11 (IO_B7), U18.4 (A4)
ZB23: OB23.1 (A), U4.B16 (IO_B6), U18.8 (A6)
ZB24: OB24.1 (A), U4.G11 (IO_B6), U18.10 (A8)
ZB25: OB25.1 (A), U4.D15 (IO_B6), U19.2 (A2)
ZB26: OB26.1 (A), U4.D16 (IO_B6), U19.4 (A4)
ZB27: OB27.1 (A), U4.F15 (IO_B6), U19.8 (A6)
ZB28: OB28.1 (A), U19.10 (A8); also elsewhere on the board
ZB29: OB29.1 (A), U4.G15 (IO_B6), U20.2 (A2)
ZB30: OB30.1 (A), U20.4 (A4); also elsewhere on the board
ZB31: OB31.1 (A), U20.8 (A6); also elsewhere on the board
ZB32: OB32.1 (A), U20.10 (A8); also elsewhere on the board
ZOE: U4.E10 (IO_B7), U13.6 (OE), U14.6 (OE), U15.6 (OE), U16.6 (OE), U17.6 (OE), U18.6 (OE), U19.6 (OE), U20.6 (OE)
