andreili/UniEmu/hardware/UniEmu.kicad_pcb

## KiCad design hardware/UniEmu.kicad_pcb (continued)

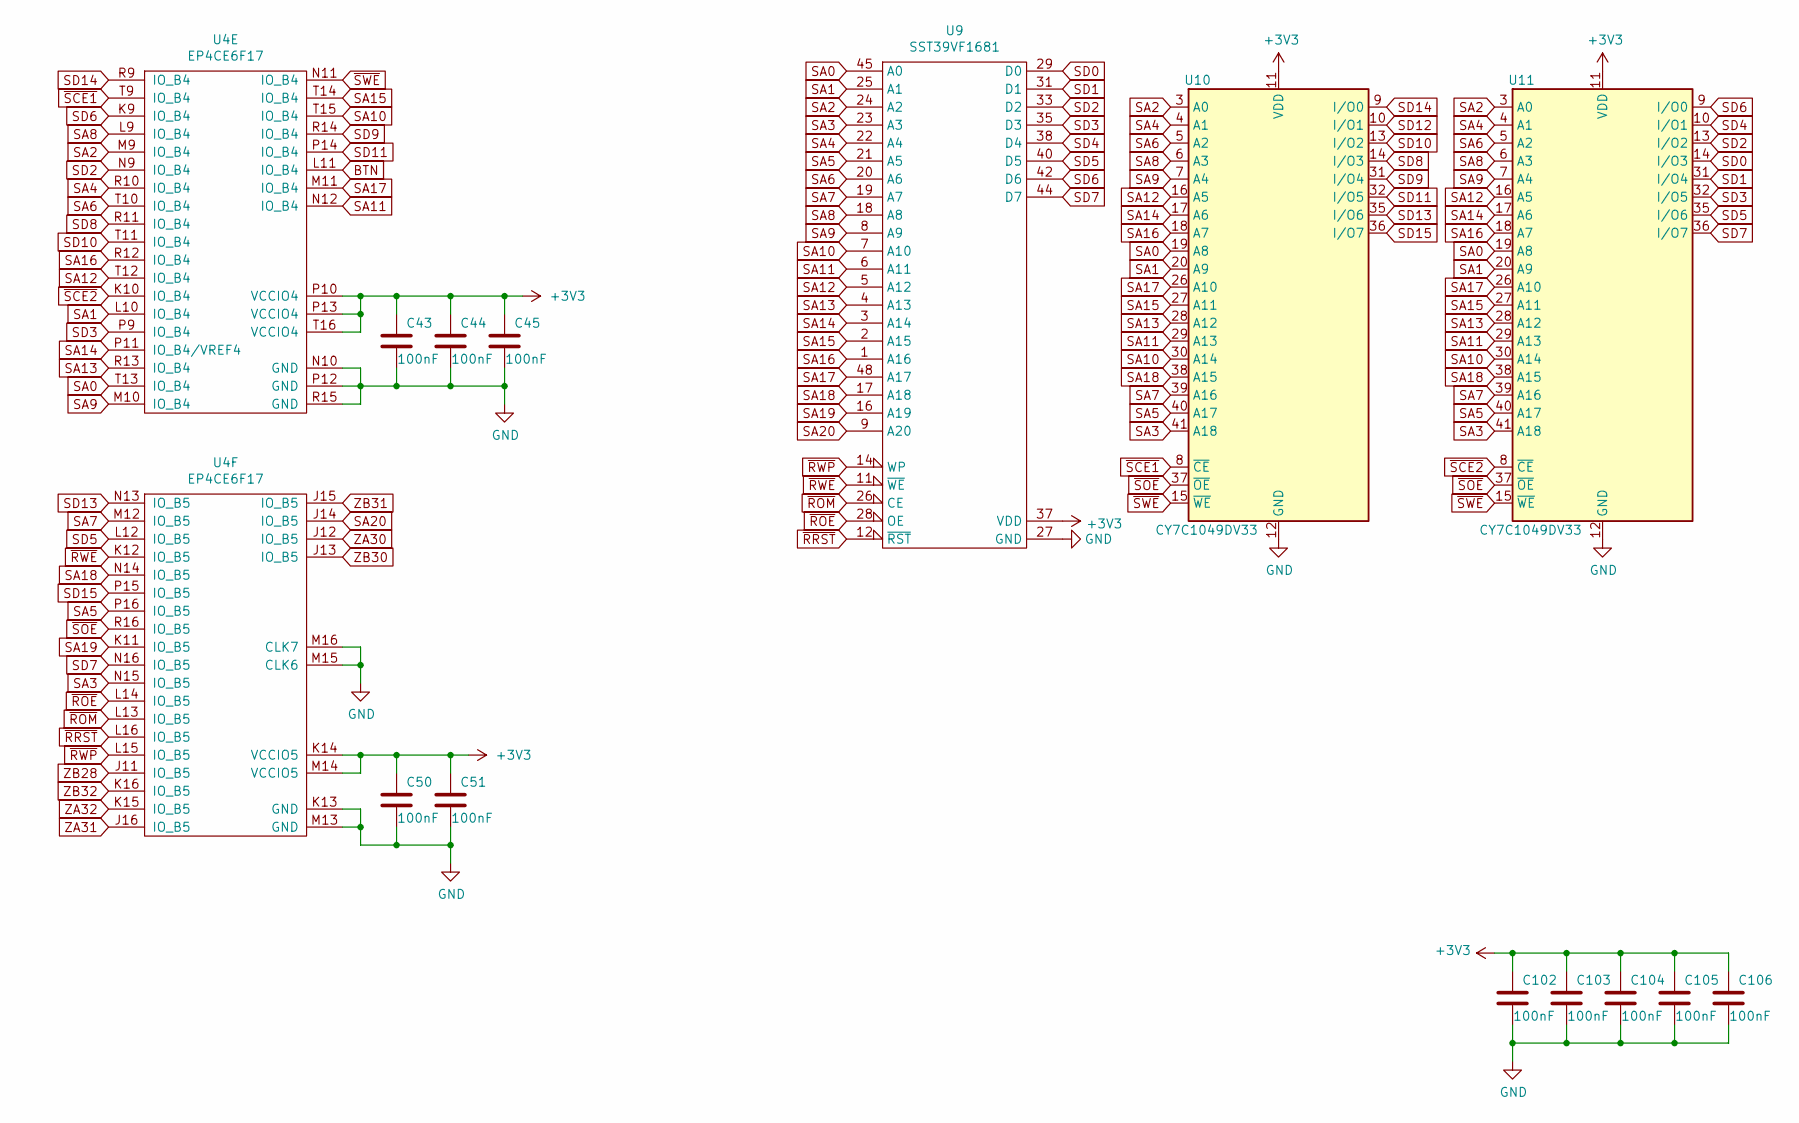
[picture p5: schematic MPC.sch]

Parts:
C43, C44, C45, C50, C51, C102, C103, C104, C105, C106: 100nF; C_0805_2012Metric
U4: EP4CE6F17; BGA-256_17.0x17.0mm_Layout16x16_P1.0mm_Ball0.5mm_Pad0.4mm_N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
U9: SST39VF1681; TSOP-I-48_18.4x12mm_P0.5mm
U10, U11: CY7C1049DV33; TSOP-II-44_10.16x18.41mm_P0.8mm

Connections:
BTN: U4.L11 (IO_B4); also elsewhere on the board
GND: C43.2, C44.2, C45.2, C50.2, C51.2, C102.2, C103.2, C104.2, C105.2, C106.2, U4.K13 (GND), U4.M13 (GND), U4.M15 (CLK6), U4.M16 (CLK7), U4.N10 (GND), U4.P12 (GND), U4.R15 (GND), U9.27 (GND), U10.12 (GND), U10.34 (GND), U11.12 (GND), U11.34 (GND); also elsewhere on the board
SA0: U4.T13 (IO_B4), U9.45 (A0), U10.19 (A8), U11.19 (A8)
SA1: U4.L10 (IO_B4), U9.25 (A1), U10.20 (A9), U11.20 (A9)
SA2: U4.M9 (IO_B4), U9.24 (A2), U10.3 (A0), U11.3 (A0)
SA3: U4.N15 (IO_B5), U9.23 (A3), U10.41 (A18), U11.41 (A18)
SA4: U4.R10 (IO_B4), U9.22 (A4), U10.4 (A1), U11.4 (A1)
SA5: U4.P16 (IO_B5), U9.21 (A5), U10.40 (A17), U11.40 (A17)
SA6: U4.T10 (IO_B4), U9.20 (A6), U10.5 (A2), U11.5 (A2)
SA7: U4.M12 (IO_B5), U9.19 (A7), U10.39 (A16), U11.39 (A16)
SA8: U4.L9 (IO_B4), U9.18 (A8), U10.6 (A3), U11.6 (A3)
SA9: U4.M10 (IO_B4), U9.8 (A9), U10.7 (A4), U11.7 (A4)
SA10: U4.T15 (IO_B4), U9.7 (A10), U10.30 (A14), U11.30 (A14)
SA11: U4.N12 (IO_B4), U9.6 (A11), U10.29 (A13), U11.29 (A13)
SA12: U4.T12 (IO_B4), U9.5 (A12), U10.16 (A5), U11.16 (A5)
SA13: U4.R13 (IO_B4), U9.4 (A13), U10.28 (A12), U11.28 (A12)
SA14: U4.P11 (IO_B4/VREF4), U9.3 (A14), U10.17 (A6), U11.17 (A6)
SA15: U4.T14 (IO_B4), U9.2 (A15), U10.27 (A11), U11.27 (A11)
SA16: U4.R12 (IO_B4), U9.1 (A16), U10.18 (A7), U11.18 (A7)
SA17: U4.M11 (IO_B4), U9.48 (A17), U10.26 (A10), U11.26 (A10)
SA18: U4.N14 (IO_B5), U9.17 (A18), U10.38 (A15), U11.38 (A15)
SA19: U4.K11 (IO_B5), U9.16 (A19)
SA20: U4.J14 (IO_B5), U9.9 (A20)
SD0: U9.29 (D0), U11.14 (I/O3); also elsewhere on the board
SD1: U9.31 (D1), U11.31 (I/O4); also elsewhere on the board
SD2: U4.N9 (IO_B4), U9.33 (D2), U11.13 (I/O2)
SD3: U4.P9 (IO_B4), U9.35 (D3), U11.32 (I/O5)
SD4: U9.38 (D4), U11.10 (I/O1); also elsewhere on the board
SD5: U4.L12 (IO_B5), U9.40 (D5), U11.35 (I/O6)
SD6: U4.K9 (IO_B4), U9.42 (D6), U11.9 (I/O0)
SD7: U4.N16 (IO_B5), U9.44 (D7), U11.36 (I/O7)
SD8: U4.R11 (IO_B4), U10.14 (I/O3)
SD9: U4.R14 (IO_B4), U10.31 (I/O4)
SD10: U4.T11 (IO_B4), U10.13 (I/O2)
SD11: U4.P14 (IO_B4), U10.32 (I/O5)
SD12: U10.10 (I/O1); also elsewhere on the board
SD13: U4.N13 (IO_B5), U10.35 (I/O6)
SD14: U4.R9 (IO_B4), U10.9 (I/O0)
SD15: U4.P15 (IO_B5), U10.36 (I/O7)
VREF: C43.1, C44.1, C45.1, C50.1, C51.1, C102.1, C103.1, C104.1, C105.1, C106.1, U4.K14 (VCCIO5), U4.M14 (VCCIO5), U4.P10 (VCCIO4), U4.P13 (VCCIO4), U4.T16 (VCCIO4), U9.37 (VDD), U10.11 (VDD), U10.33 (VDD), U11.11 (VDD), U11.33 (VDD); also elsewhere on the board
ZA30: U4.J12 (IO_B5); also elsewhere on the board
ZA31: U4.J16 (IO_B5); also elsewhere on the board
ZA32: U4.K15 (IO_B5); also elsewhere on the board
ZB28: U4.J11 (IO_B5); also elsewhere on the board
ZB30: U4.J13 (IO_B5); also elsewhere on the board
ZB31: U4.J15 (IO_B5); also elsewhere on the board
ZB32: U4.K16 (IO_B5); also elsewhere on the board
~ROE: U4.L14 (IO_B5), U9.28 (OE)
~ROM: U4.L13 (IO_B5), U9.26 (CE)
~RRST: U4.L16 (IO_B5), U9.12 (~RST)
~RWE: U4.K12 (IO_B5), U9.11 (~WE)
~RWP: U4.L15 (IO_B5), U9.14 (WP)
~SCE1: U4.T9 (IO_B4), U10.8 (~CE)
~SCE2: U4.K10 (IO_B4), U11.8 (~CE)
~SOE: U4.R16 (IO_B5), U10.37 (~OE), U11.37 (~OE)
~SWE: U4.N11 (IO_B4), U10.15 (~WE), U11.15 (~WE)

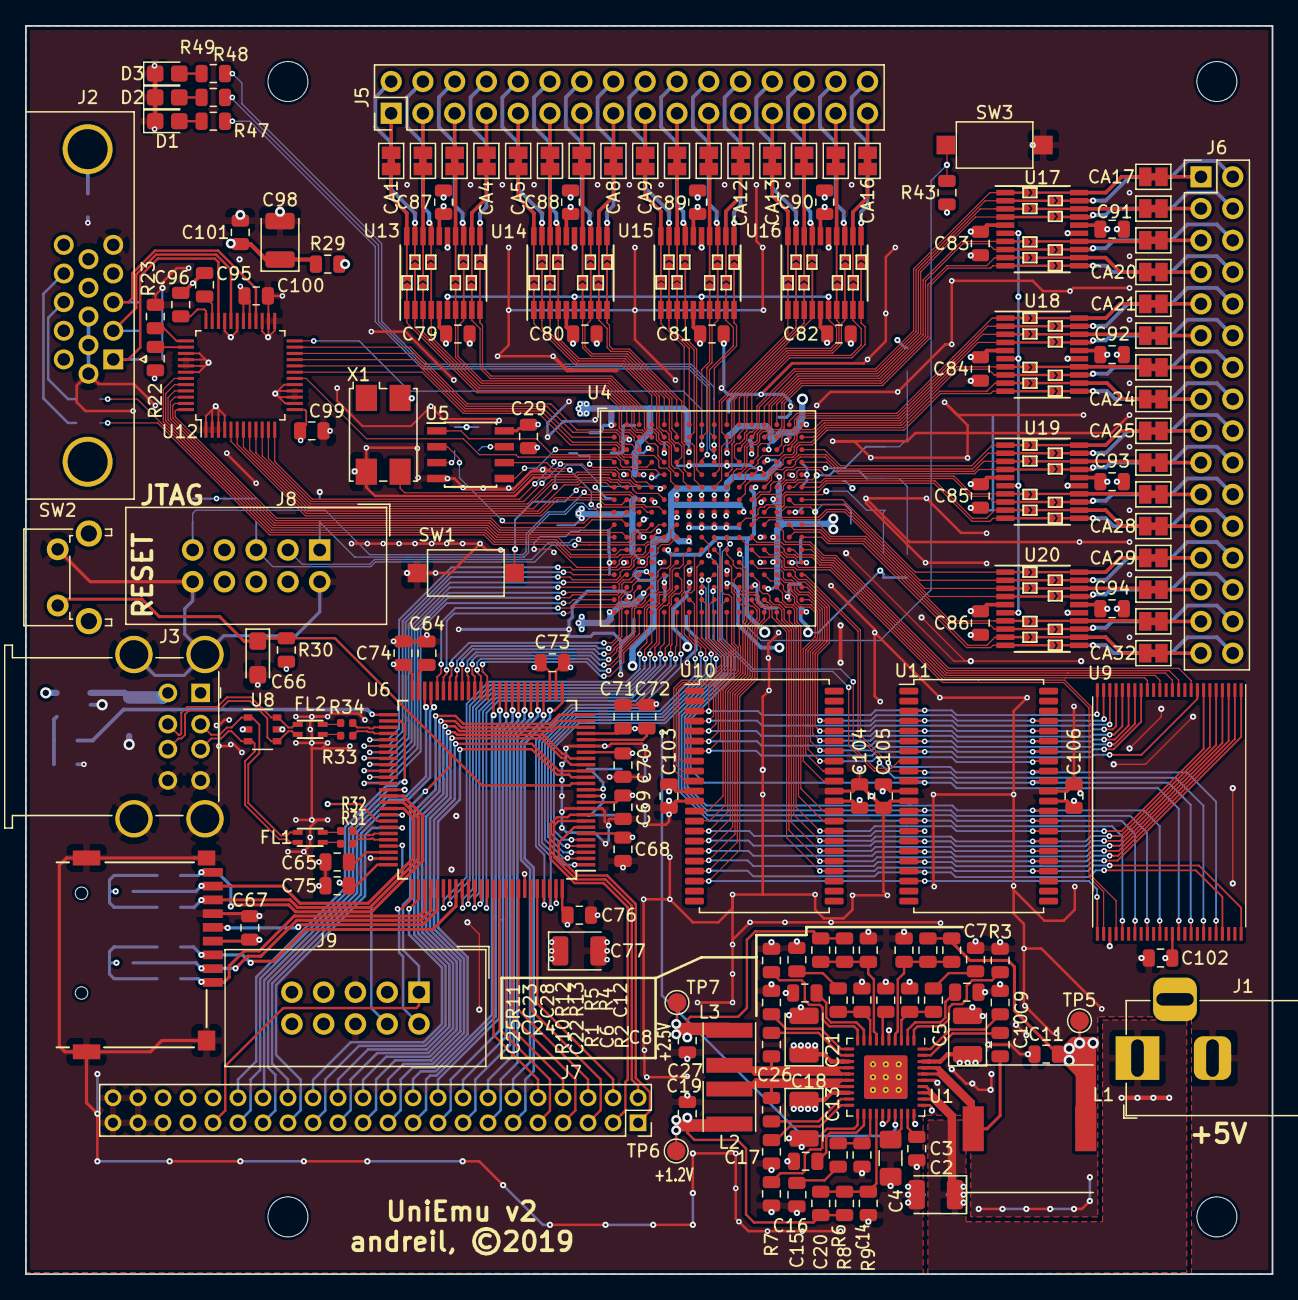
[picture p6: board UniEmu.kicad_pcb from above]

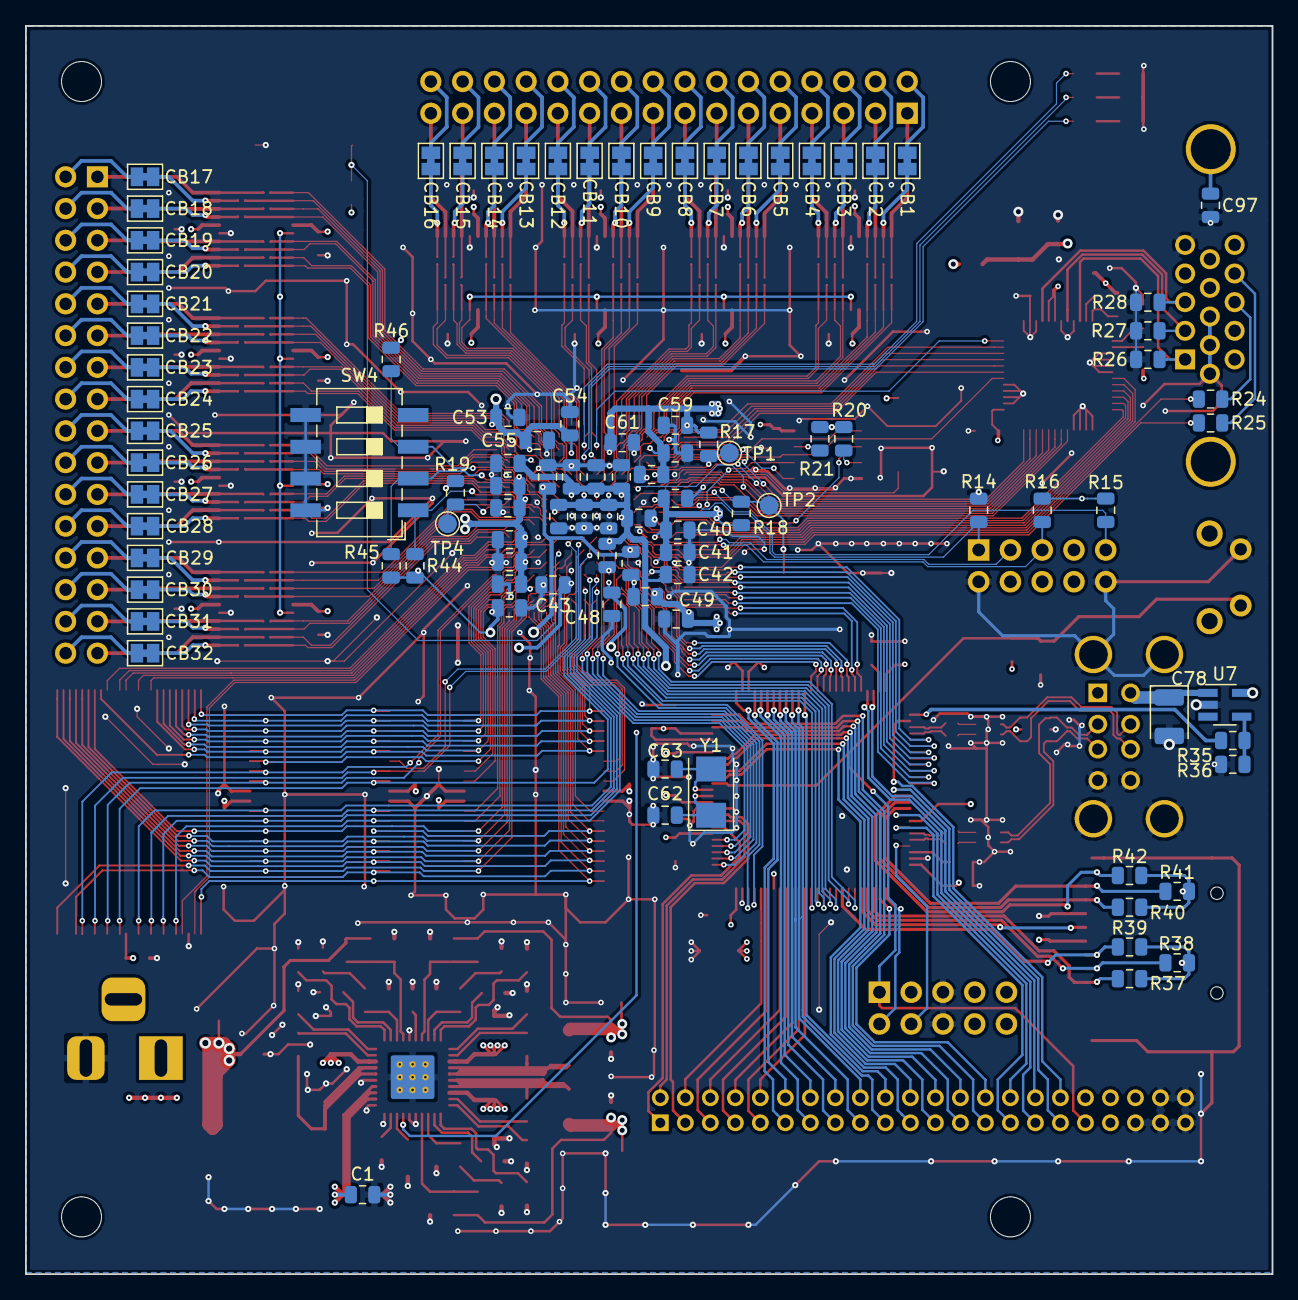
[picture p7: board UniEmu.kicad_pcb from below]

Board: 4 copper layers, 99.7 x 99.8 mm, 330 parts (99 on the bottom side), 423 nets.
