andreili/UniEmu/software/inc/main.h

#ifndef MAIN_H
#define MAIN_H

#include "stm32_inc.h"
#include "xprintf.h"
#include "sddriver.h"
#include "mscdriver.h"
#ifdef STM32_USE_USBH_HID
    #include "usbh_hid.h"
#endif //STM32_USE_USBH_HID
#ifdef STM32_USE_USBH_MSC
    #include "usbh_msc.h"
#endif //STM32_USE_USBH_MSC

#include "overlay.h"

extern void (*main_fw_jump)(void);

extern TCHAR SD_path[4], msc_path[2][4];
extern FATFS MSCFatFS[2];
extern SDDriver sd_driver;
extern MSCDriver msc_driver[2];

extern USBH_HID usbh_hid[2];
extern USBH_MSC usbh_msc[2];

void USBH_init();
void FAT_init();
void UNI_init();

#endif //MAIN_H
