andreili/UniEmu/software_boot/src/main.cpp

#include "main.h"

void xfunc_out(unsigned char c)
{
    UART.send_char(c);
}

void (*main_fw_jump)(void);

#ifdef STM32_USE_USB
void usb_fs_proc(USBHCore* core, USBHCore::EHostUser reason)
{
    UNUSED(core);
    switch (reason)
    {
    case USBHCore::EHostUser::SELECT_CONFIGURATION:
        USBH_DbgLog("Select configuration");
        break;
    case USBHCore::EHostUser::CLASS_ACTIVE:
        USBH_DbgLog("Class active");
        break;
    case USBHCore::EHostUser::CLASS_SELECTED:
        USBH_DbgLog("Class selected");
        break;
    case USBHCore::EHostUser::CONNECTION:
        USBH_DbgLog("Connection");
        break;
    case USBHCore::EHostUser::DISCONNECTION:
        USBH_DbgLog("Disconnection");
        break;
    case USBHCore::EHostUser::UNRECOVERED_ERROR:
        USBH_DbgLog("Unrecovered error");
        break;
    }
}

void disconnect_callback(STM32_HCD *hcd)
{
    static_cast<USBHCore*>(hcd->get_data())->LL_disconnect();
    USBH_DbgLog("USB disconnected");
}

void connect_callback(STM32_HCD *hcd)
{
    static_cast<USBHCore*>(hcd->get_data())->LL_connect();
    USBH_DbgLog("USB connected");
}

void SOF_callback(STM32_HCD *hcd)
{
    static_cast<USBHCore*>(hcd->get_data())->LL_inc_timer();
}

void HC_notify_URB_change_callback(STM32_HCD *hcd, uint8_t ch_num, STM32_HCD::EURBState urb_state)
{
#if (USBH_USE_OS == 1)
    reinterpret_cast<USBHCore*>(hcd->get_data())->LL_notify_URB_change();
#else
    UNUSED(hcd);
#endif
    UNUSED(ch_num);
    UNUSED(urb_state);
}
#endif

#ifdef STM32_USE_USB
TCHAR msc_path[2][4];
FATFS MSCFatFS[2];
MSCDriver msc_driver[2];
#endif
#ifdef STM32_USE_SD
TCHAR SD_path[4];
SDDriver sd_driver;
FATFS SDFatFS;
#endif

#ifdef STM32_USE_USB
USBH_MSC usbh_msc[2];
#endif

TProcWorker ProcWorker;
#ifndef STM32_USE_USB
TProcUSBNULL ProcUSBNULL;
#endif

int main()
{
    LED_PORT.set_config(LED1_PIN | LED2_PIN | LED3_PIN, STM32_GPIO::EMode::OUTPUT_PP, STM32_GPIO::EAF::NONE, STM32_GPIO::ESpeed::LOW, STM32_GPIO::EPull::NOPULL);
    LED_PORT.pin_OFF(LED1_PIN | LED2_PIN | LED3_PIN);
    UART.init(STM32_BRATE_UART6);
    UART.send_str("\n\rUniEmu bootloader\n\r", TXRX_MODE::DIRECT);
    #ifdef STM32_USE_USB
    USBH_init();
    #endif
    FAT_init();

    OS::run();

    while (1)
    {
    }
}

#ifdef STM32_USE_USB
void USBH_init()
{
    STM32_USB_PWR_FS_PORT.set_config(STM32_USB_PWR_FS_PIN, STM32_GPIO::EMode::OUTPUT_PP, STM32_GPIO::EAF::NONE, STM32_GPIO::ESpeed::LOW, STM32_GPIO::EPull::PULLUP);
    STM32_USB_PWR_FS_PORT.pin_OFF(STM32_USB_PWR_FS_PIN);

    usb_FS.init(usb_fs_proc, HOST_FS);
    usb_FS.register_class(&usbh_msc[HOST_FS]);
    usb_FS.start();

    usb_HS.init(usb_fs_proc, HOST_HS);
    usb_HS.register_class(&usbh_msc[HOST_HS]);
    usb_HS.start();
}
#endif

void FAT_init()
{
    FAT_FS::init();
    #ifdef STM32_USE_USB
    msc_driver[HOST_FS].link_data(reinterpret_cast<void*>(&usbh_msc[HOST_FS]));
    msc_driver[HOST_HS].link_data(reinterpret_cast<void*>(&usbh_msc[HOST_HS]));
    FAT_FS::link_driver(&msc_driver[HOST_FS], msc_path[HOST_FS], 0);
    FAT_FS::link_driver(&msc_driver[HOST_HS], msc_path[HOST_HS], 0);
    #endif
    #ifdef STM32_USE_SD
    sd_driver.init_gpio();
    FAT_FS::link_driver(&sd_driver, SD_path, 0);
    #endif
}

void __attribute__((noreturn)) Error_Handler()
{
    while (1)
        LED_PORT.pin_ON(LED3_PIN);
}

enum class EInitStep: uint8_t
{
    UP_WAIT     = 0,
    UP_READY    = 0x10,
    UP_MOUNT    = 0x11,
    UP_CHECK    = 0x12,
};

namespace OS
{
    template <>
    OS_PROCESS void TProcWorker::exec()
    {
        #ifdef STM32_USE_USB
        bool msc_mounted[2];
        msc_mounted[0] = false;
        msc_mounted[1] = false;
        FATFS *fs = &MSCFatFS[HOST_FS];
        char *path = msc_path[HOST_FS];
        #else
        FATFS *fs = &SDFatFS;
        char *path = SD_path;
        #endif
        bool sd_mounted;
        sd_mounted = false;
        bool updated = false;
        EInitStep step_init = EInitStep::UP_WAIT;
        int cnt = 0;
        bool *is_mounted = &sd_mounted;
        #ifdef STM32_USE_USB
        USBH_MSC *msc = &usbh_msc[HOST_FS];
        #endif
        FRESULT res;
        for(;;)
        {
            switch (step_init)
            {
            case EInitStep::UP_WAIT:
                #ifdef STM32_USE_USB
                if ((usb_FS.get_active_class() != nullptr) &&
                    (usb_FS.get_active_class()->get_class_code() == USB_MSC_CLASS) &&
                    (!msc_mounted[HOST_FS]))
                {
                    xprintf("Check FS MSC\n\r");
                    is_mounted = &msc_mounted[HOST_FS];
                    msc = &usbh_msc[HOST_FS];
                    fs = &MSCFatFS[HOST_FS];
                    path = msc_path[HOST_FS];
                    step_init = EInitStep::UP_READY;
                    break;
                }
                if ((usb_HS.get_active_class() != nullptr) &&
                    (usb_HS.get_active_class()->get_class_code() == USB_MSC_CLASS) &&
                    (!msc_mounted[HOST_HS]))
                {
                    xprintf("Check HS MSC\n\r");
                    is_mounted = &msc_mounted[HOST_HS];
                    msc = &usbh_msc[HOST_HS];
                    fs = &MSCFatFS[HOST_HS];
                    path = msc_path[HOST_HS];
                    step_init = EInitStep::UP_READY;
                    break;
                }
                #endif
                #ifdef STM32_USE_SD
                if (sd_driver.is_card_present() && (!sd_mounted))
                {
                    xprintf("Check SD\n\r");
                    is_mounted = &sd_mounted;
                    fs = &SDFatFS;
                    path = SD_path;
                    step_init = EInitStep::UP_MOUNT;
                    break;
                }
                #endif
                break;
            case EInitStep::UP_READY:
                #ifdef STM32_USE_USB
                if (msc->is_ready())
                {
                    cnt = 0;
                    xprintf("Wait mount\n\r");
                    step_init = EInitStep::UP_MOUNT;
                }
                #endif
                break;
            case EInitStep::UP_MOUNT:
                if (*is_mounted || ((res = f_mount(fs, path, 1)) == FR_OK))
                {
                    *is_mounted = true;
                    xprintf("Mounted path: '%s'\n\r", path);
                    step_init = EInitStep::UP_CHECK;
                }
                break;
            case EInitStep::UP_CHECK:
                xprintf("Check updates\n\r");
                if (check_updates(path[0]))
                    updated = true;
                else
                {
                    xprintf("Next...\n\r");
                    step_init = EInitStep::UP_WAIT;
                    cnt = 0;
                }
                break;
            }
            if (updated || (++cnt > 1000))
                break;
            sleep(1);
        }

        main_fw_jump = reinterpret_cast<void (*)(void)>(*(reinterpret_cast<uint32_t*>(FW_START_ADDR + 4)));
        xprintf("Jump to main firmware (0x%08X)\n\r\n\r", main_fw_jump);

        // stop used peripheral
        UART.deinit();
        #ifdef STM32_USE_SD
        STM32_SD::deinit();
        #endif
        #ifdef STM32_USE_USB
        usb_FS.stop();
        usb_HS.stop();
        usb_FS.deInit();
        usb_HS.deInit();
        #endif
        tim14.deinit();

        __disable_irq();
        STM32_RCC::deinit_per();
        STM32_NVIC::deInit();
        STM32_SYSTICK::deinit();
        STM32_RCC::deinit();
        SCB->VTOR = FW_START_ADDR;
        STM32_FLASH::enable_remap_system_flash();
        __set_CONTROL(0x00);
        __set_MSP(*reinterpret_cast<uint32_t*>(FW_START_ADDR));
        main_fw_jump();
        while (1);
    }
}

#ifndef STM32_USE_USB
namespace OS
{
    template <>
    OS_PROCESS void TProcUSBNULL::exec()
    {
        while (1)
        {
        }
    }
}
#endif

#if scmRTOS_IDLE_HOOK_ENABLE
void OS::idle_process_user_hook()
{
    __WFI();
}
#endif

extern "C" void __init_system_timer()
{
    STM32_SYSTICK::init();
}

void ISR::SysTickTimer()
{
    OS::system_timer_isr();
    OS::raise_context_switch();
}
