andreili/UniEmu/(commit log)

2019-04-28 Inital commit
    [MCP_bus.sch, MCU.sch, MPC.sch, MPC_VIDEO.sch, UniEmu.kicad_pcb, UniEmu.sch, out_buck.xlsx]
2019-05-24 Обновлен загрузчик
2019-05-24 Обновлена схема:
    1. Исправлена нумерация CS SRAM;
    2. Исправлена нумерация сигналов для светодиодов.
    [MCP_bus.sch, MPC.sch, UniEmu.sch]
2019-05-24 Добавлена заготовка основной прошивки
2019-05-24 Обновлён .gitignore
2019-05-24 Добавлена черновая версия реализации ORION-NG
2019-05-24 Исправлен переход на основную прошивку
    [main.cpp]
2019-05-25 Bootloader: Исправлено для условной компиляции без USB.
    [main.cpp, main.h, updater.cpp]
2019-05-26 Обновлён загрузчик
2019-05-26 Добавлены отсутствующие файлы
2019-05-26 Исправлена процедура обновления прошивки
    [ffconf.h, updater.cpp]
2019-05-26 Исправлено переключение контекста при переходе на основную прошивку
    [main.cpp]
2019-06-05 Из загрузчика убрана поддрежка USBH HID - требовалось для тестов
