andreili/UniEmu/(notices)

Notices in the files:
software/inc/scmRTOS_CONFIG.h:
Copyright (c) 2003-2016, scmRTOS Team
GCC STM32F4xx samples by Anton B. Gusev aka AHTOXA, Copyright (c) 2009-2016
hardware/UniEmu.kicad_pcb:
andreil, ©2019
